lengyela89/Renault-BT/(threads)

Thread 5 (2020-01-20):

Review - CDCE & CDCEM

lengyela89, 2020-01-20:
Fix separator comments in CDCE and CDCEM!

Create API documentation in CDCE and CDCEM!

Replace tabs with spaces!

Create error frame on emulator error, which contains the needed information for debugging:
- error code
- state before error
- error context: additional information

lengyela89, 2020-01-29:
Complex error handling for the CDC Emulator will be implemented later.

Closed 2020-01-29.

Thread 6 (2021-02-24):

Improve error handling

lengyela89, 2021-02-24:
Improve error handling:
 - indicate different type of errors differently on the board
 - use built-in display to inform user about the error
