lengyela89/Renault-BT/Schematics/export/RenaultBT.pdf

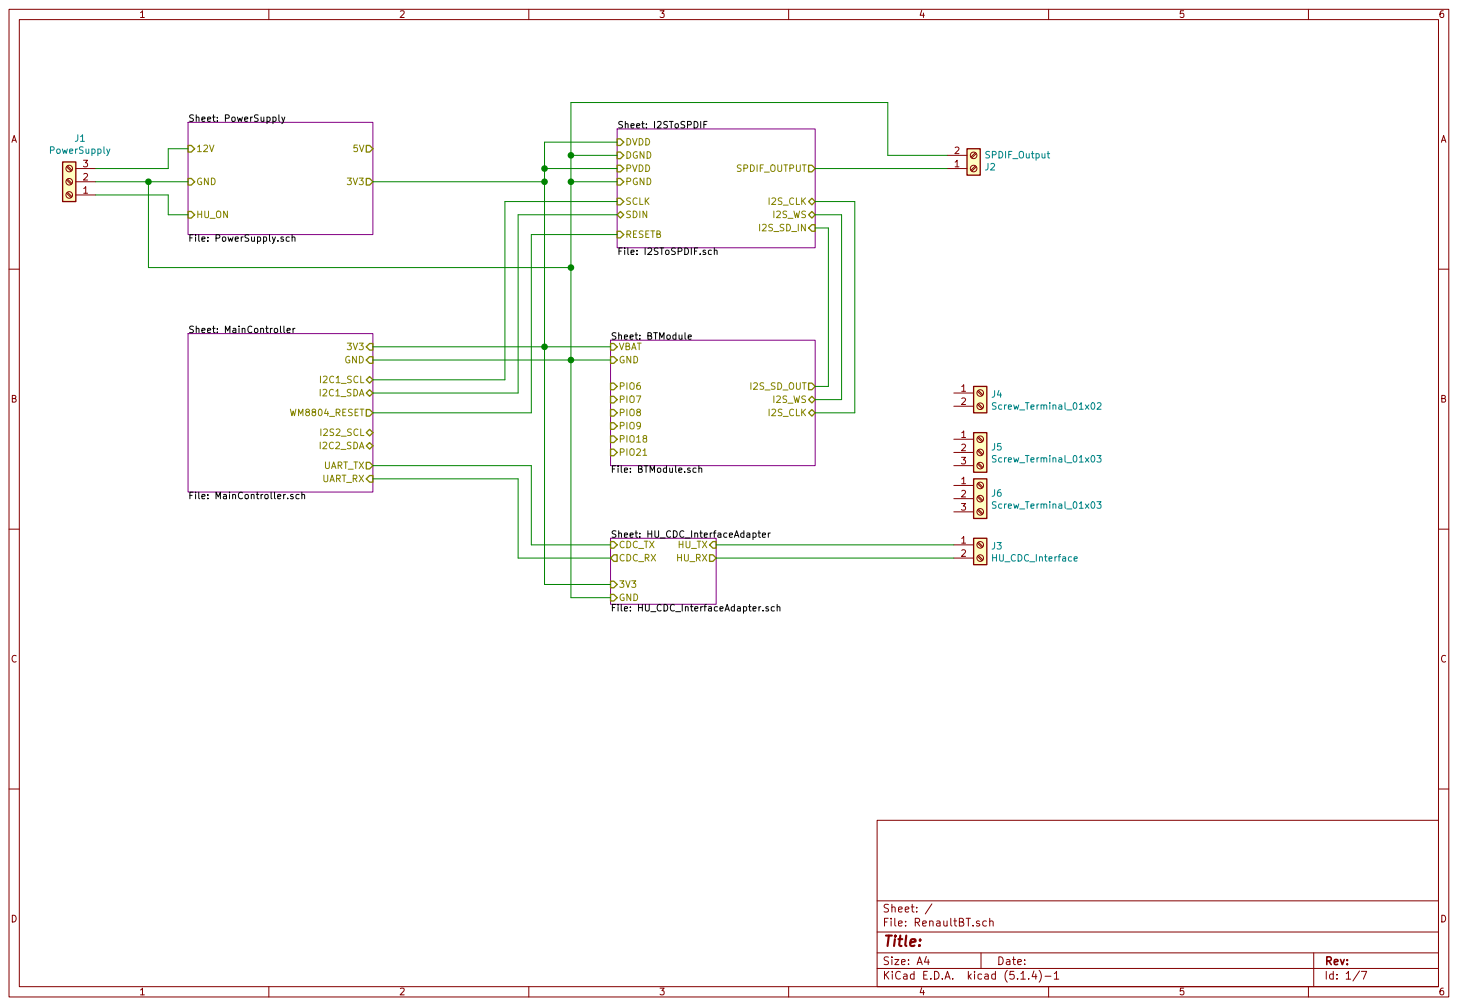
[picture p1: page 1]

3V3 Sheet: MainController File: MainController.sch

Sheet: BTModule File: BTModule.sch VBAT GND

Id: 1/7 Title: File: RenaultBT.sch Sheet: /

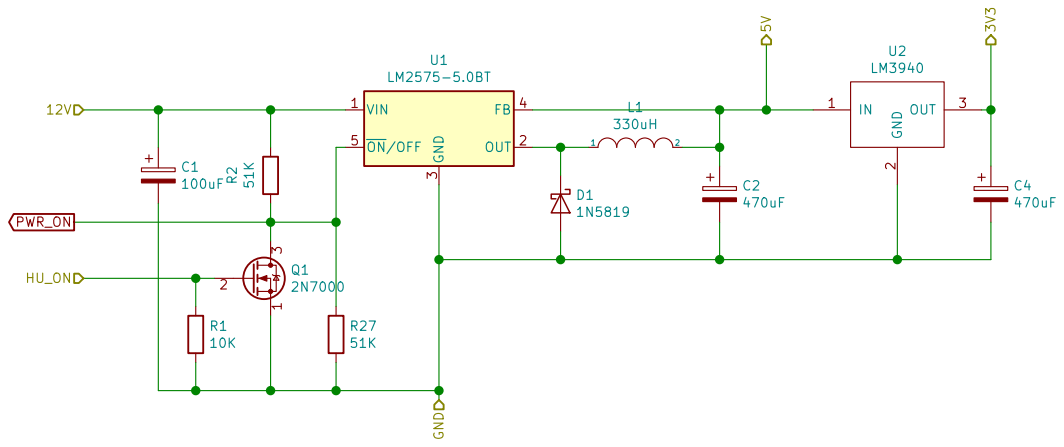
[picture p2: page 2]

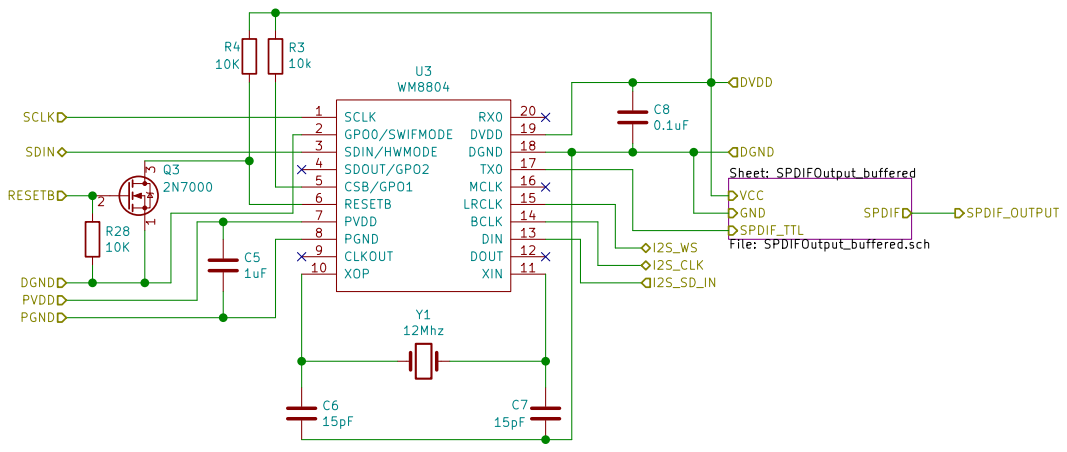
[picture p3: page 3]

Id: 3/7 Title: File: I2SToSPDIF.sch Sheet: /I2SToSPDIF/

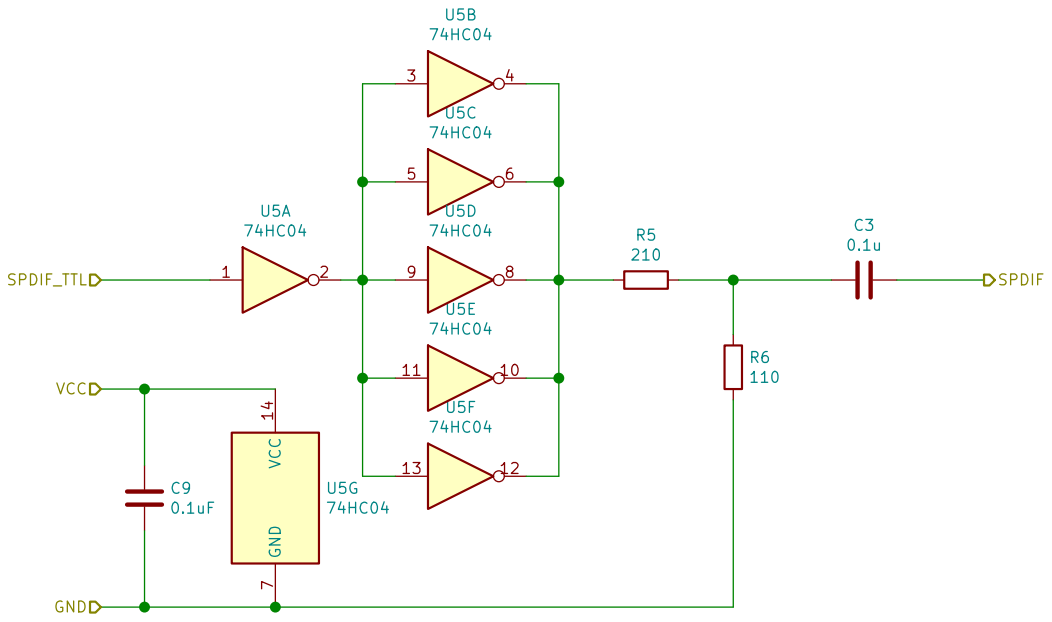
[picture p4: page 4]

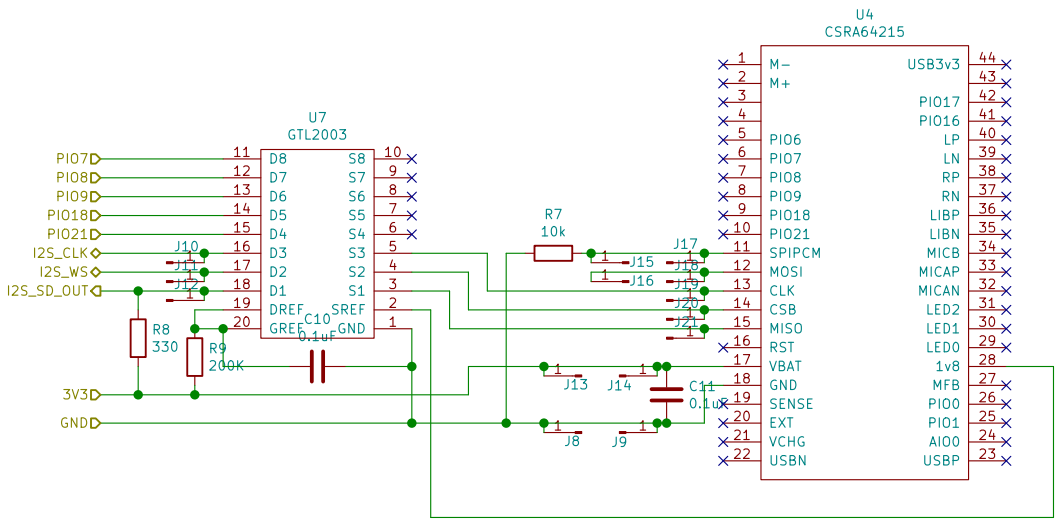
[picture p5: page 5]

Id: 5/7 Title: File: BTModule.sch Sheet: /BTModule/

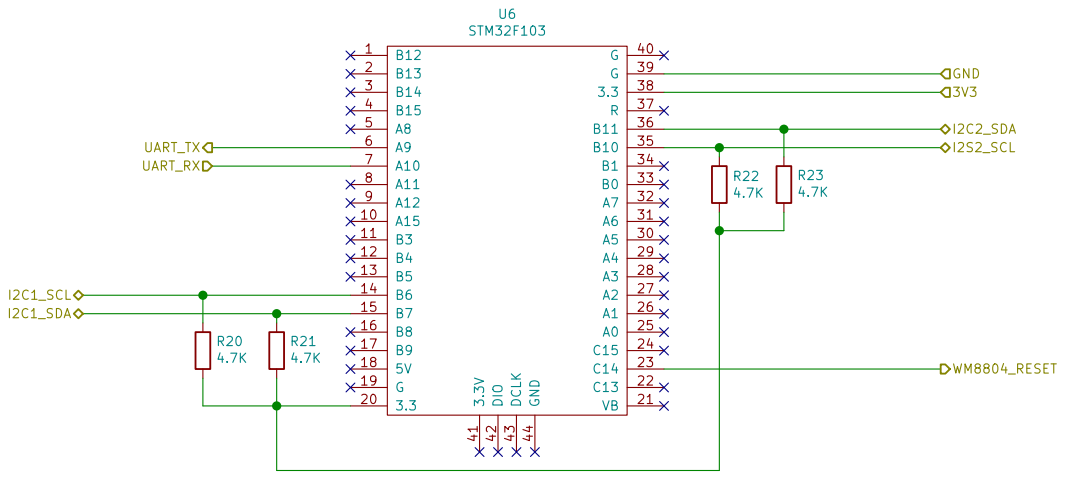
[picture p6: page 6]

Id: 6/7 Title: File: MainController.sch Sheet: /MainController/ R21

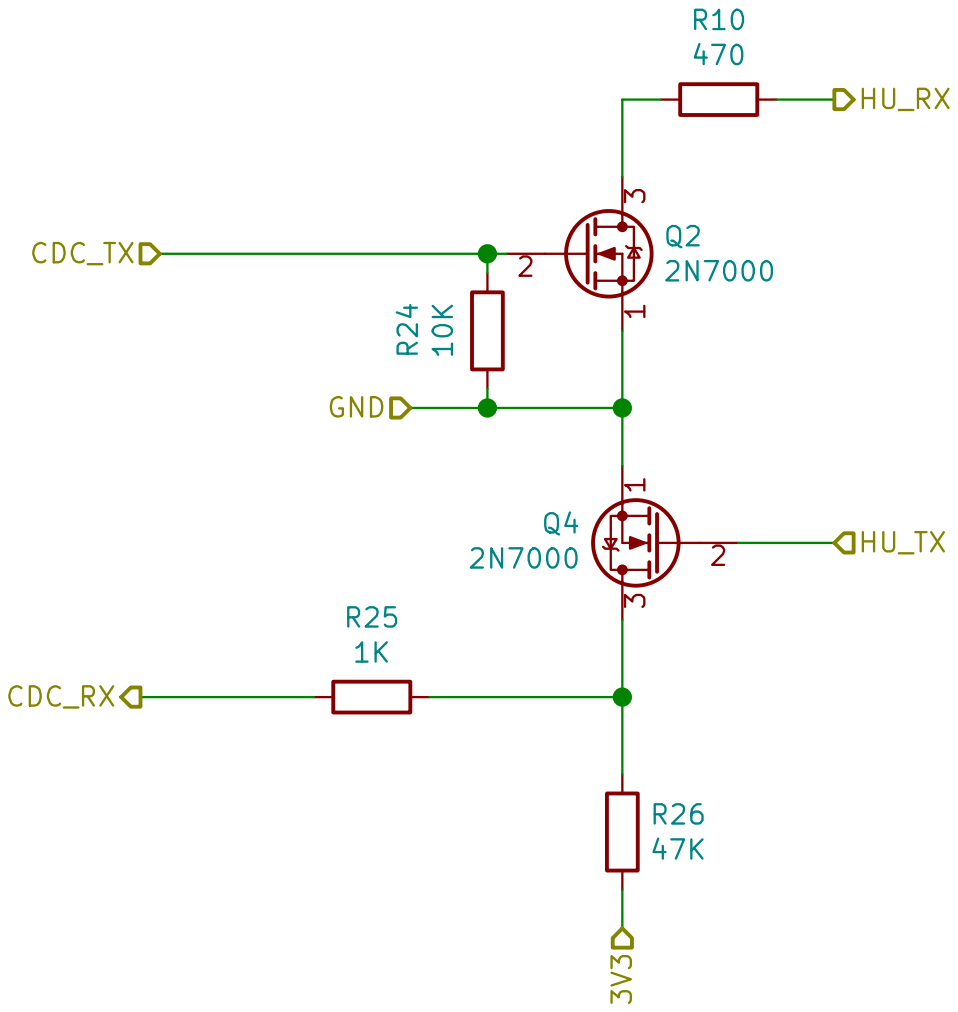
[picture p7: page 7]
