lengyela89/Renault-BT/Schematics/RenaultBT.kicad_pcb

## KiCad design Schematics/RenaultBT.kicad_pcb (2020-01-12)

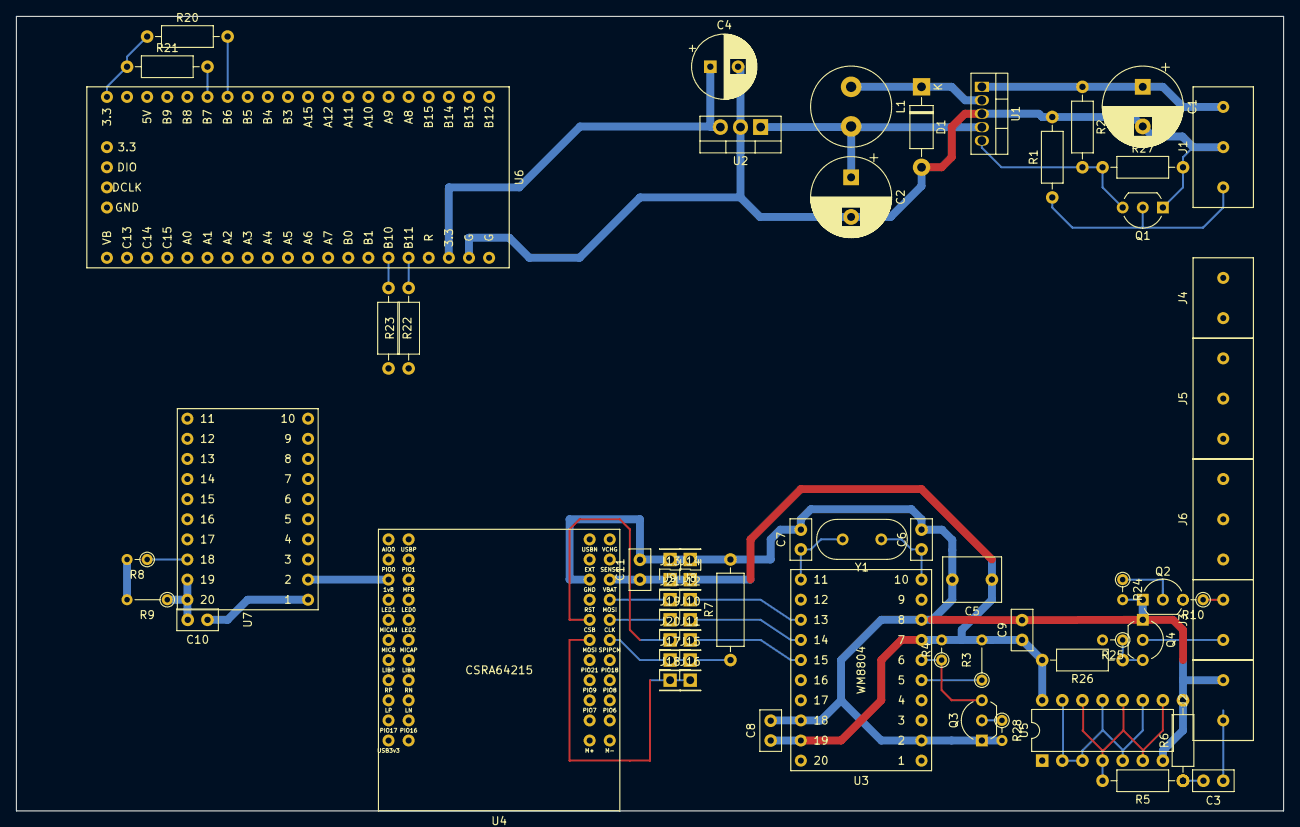
[picture p8: board RenaultBT.kicad_pcb from above]

Board: 2 copper layers, 160.0 x 100.3 mm, 64 parts (0 on the bottom side), 39 nets.

Parts:
C1: 100uF; CP_Radial_D10.0mm_P5.00mm
C2: 470uF; CP_Radial_D10.0mm_P5.00mm
C3: 0.1u; C_Disc_D5.0mm_W2.5mm_P2.50mm
C4: 470uF; CP_Radial_D8.0mm_P3.50mm
C5: 1uF; C_Rect_L7.2mm_W5.5mm_P5.00mm_FKS2_FKP2_MKS2_MKP2
C6, C7: 15pF; C_Disc_D5.0mm_W2.5mm_P2.50mm
C8, C9, C10, C11: 0.1uF; C_Disc_D5.0mm_W2.5mm_P2.50mm
D1: 1N5819; D_DO-41_SOD81_P10.16mm_Horizontal
J1: PowerSupply; ScrewTerminal_3
J2: SPDIF_Output; ScrewTerminal_2
J3: HU_CDC_Interface; ScrewTerminal_2
J4: Screw_Terminal_01x02; ScrewTerminal_2
J5, J6: Screw_Terminal_01x03; ScrewTerminal_3
J8, J9, J10, J11, J12, J13, J14, J15, J16, J17, J18, J19, J20, J21: Conn_01x01_Male; PinHeader_1x01_P2.54mm_Vertical
L1: 330uH; L_Radial_D10.0mm_P5.00mm_Fastron_07M
Q1, Q2, Q3, Q4: 2N7000; TO-92_Inline_Wide
R1: 10K; R_Axial_DIN0207_L6.3mm_D2.5mm_P10.16mm_Horizontal
R2, R27: 51K; R_Axial_DIN0207_L6.3mm_D2.5mm_P10.16mm_Horizontal
R3: 10k; R_Axial_DIN0204_L3.6mm_D1.6mm_P5.08mm_Vertical
R4, R24, R28: 10K; R_Axial_DIN0204_L3.6mm_D1.6mm_P2.54mm_Vertical
R5: 210; R_Axial_DIN0207_L6.3mm_D2.5mm_P10.16mm_Horizontal
R6: 110; R_Axial_DIN0207_L6.3mm_D2.5mm_P10.16mm_Horizontal
R7: 10k; R_Axial_DIN0309_L9.0mm_D3.2mm_P12.70mm_Horizontal
R8: 330; R_Axial_DIN0204_L3.6mm_D1.6mm_P2.54mm_Vertical
R9: 200K; R_Axial_DIN0204_L3.6mm_D1.6mm_P5.08mm_Vertical
R10: 470; R_Axial_DIN0204_L3.6mm_D1.6mm_P2.54mm_Vertical
R20, R21, R22, R23: 4.7K; R_Axial_DIN0207_L6.3mm_D2.5mm_P10.16mm_Horizontal
R25: 1K; R_Axial_DIN0204_L3.6mm_D1.6mm_P2.54mm_Vertical
R26: 47K; R_Axial_DIN0207_L6.3mm_D2.5mm_P10.16mm_Horizontal
U1: LM2575-5.0BT; TO-220-5_Vertical
U2: LM3940; TO-220-3_Vertical
U3: WM8804; WM8804_Breakout_18mm_x_25mm
U4: CSRA64215
U5: 74HC04; DIP-14_W7.62mm
U6: STM32F103; STM32F103C8T6
U7: GTL2003
Y1: 12Mhz; Crystal_HC49-4H_Vertical

Connections:
/BTModule/3V3: C11.1, J13.1, J14.1, R8.2, R9.2, U4.17
/BTModule/I2S_CLK: J10.1, U3.14, U7.16
/BTModule/I2S_WS: J11.1, U3.15, U7.17
/HU_CDC_InterfaceAdapter/3V3: C4.1, C5.1, C8.1, C9.1, R3.2, R4.2, R26.2, U2.3, U3.7, U3.19, U5.14, U6.38
/HU_CDC_InterfaceAdapter/CDC_RX: R25.2, U6.7
/HU_CDC_InterfaceAdapter/CDC_TX: Q2.2, R24.1, U6.6
/HU_CDC_InterfaceAdapter/HU_RX: J3.2, R10.1
/HU_CDC_InterfaceAdapter/HU_TX: J3.1, Q4.2
/I2SToSPDIF/DGND: C1.2, C2.2, C4.2, C5.2, C6.2, C7.2, C8.2, C9.2, C10.1, C11.2, D1.2, J1.2, J2.2, J8.1, J9.1, Q1.1, Q2.1, Q3.1, Q4.1, R1.2, R6.2, R7.2, R24.2, R27.2, R28.2, U1.3, U2.2, U3.2, U3.8, U3.18, U4.18, U5.7, U6.39, U7.1
/I2SToSPDIF/I2S_SD_IN: J12.1, R8.1, U3.13, U7.18
/I2SToSPDIF/RESETB: Q3.2, R28.1, U6.23
/I2SToSPDIF/SPDIFOutput_buffered/SPDIF_TTL: U3.17, U5.1
/I2SToSPDIF/SPDIF_OUTPUT: C3.1, J2.1
/MainController/I2C1_SCL: R20.2, U3.1, U6.14
/MainController/I2C1_SDA: R21.2, U3.3, U6.15
/MainController/I2C2_SDA: R23.2, U6.36
/MainController/I2S2_SCL: R22.1, U6.35
/PowerSupply/5V: C2.1, L1.2, U1.4, U2.1
/PowerSupply/12V: C1.1, J1.3, R2.1, U1.1
/PowerSupply/HU_ON: J1.1, Q1.2, R1.1
unnamed: C3.2, R5.1, R6.1
unnamed: C6.1, U3.10, Y1.1
unnamed: C7.1, U3.11, Y1.2
unnamed: C10.2, R9.1, U7.19, U7.20
unnamed: D1.1, L1.1, U1.2
unnamed: J15.1, J17.1, R7.1, U4.11
unnamed: J16.1, J18.1, U4.12
unnamed: J19.1, U4.13, U7.5
unnamed: J20.1, U4.14, U7.4
unnamed: J21.1, U4.15, U7.3
unnamed: Q2.3, R10.2
unnamed: Q3.3, R4.1, U3.6
unnamed: Q4.3, R25.1, R26.1
unnamed: R3.1, U3.5
unnamed: R5.2, U5.4, U5.6, U5.8, U5.10, U5.12
unnamed: R20.1, R21.1, R22.2, R23.1, U6.20
unnamed: U4.28, U7.2
unnamed: U5.2, U5.3, U5.5, U5.9, U5.11, U5.13
PWR_ON: Q1.3, R2.2, R27.1, U1.5
