lengyela89/Renault-BT/Src/main.c

/**
 ******************************************************************************
 * File Name          : main.c
 * Description        : Main program body
 ******************************************************************************
 ** This notice applies to any and all portions of this file
 * that are not between comment pairs USER CODE BEGIN and
 * USER CODE END. Other portions of this file, whether
 * inserted by the user or by software development tools
 * are owned by their respective copyright owners.
 *
 * COPYRIGHT(c) 2019 STMicroelectronics
 *
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
 ******************************************************************************
 */

/* Includes ------------------------------------------------------------------*/
#include "main.h"
#include "stm32f1xx_hal.h"

/* USER CODE BEGIN Includes */
#include <WM8804.h>
#include <CDCEmulator.h>
/* USER CODE END Includes */

I2C_HandleTypeDef hi2c1;
I2C_HandleTypeDef hi2c2;

UART_HandleTypeDef huart1;

/* USER CODE BEGIN PV */

/* USER CODE END PV */

void SystemClock_Config(void);
static void MX_GPIO_Init(void);
static void MX_I2C1_Init(void);
static void MX_I2C2_Init(void);
static void MX_USART1_UART_Init(void);

/* USER CODE BEGIN PFP */
static void errorHandling(void);
/* USER CODE END PFP */

/* USER CODE BEGIN 0 */
static void errorHandling(void)
{
    while (1)
    {
        HAL_GPIO_TogglePin(GPIOC, LED_Pin);
        HAL_Delay(500u);
    }
}
/* USER CODE END 0 */

int main(void)
{

    /* MCU Configuration----------------------------------------------------------*/

    /* Reset of all peripherals, Initializes the Flash interface and the Systick. */
    HAL_Init();

    /* Configure the system clock */
    SystemClock_Config();

    /* Initialize all configured peripherals */
    MX_GPIO_Init();
    MX_I2C1_Init();
    MX_I2C2_Init();
    MX_USART1_UART_Init();

    /* USER CODE BEGIN 2 */
    uint32_t result = WM8804_RC__OK;

    WM8804_ResetPinConfig resetPinConfig = {
        .GPIOPeripheral = WM8804_RESET_GPIO_Port,
        .GPIOPin = WM8804_RESET_Pin,
        .activeLow = false
    };

    result |= WM8804_initialize(&hi2c1, 0x76u, resetPinConfig);

    if (!result)
    {
        result |= WM8804_configureModule();
    }

    if (!result)
    {
        CDCE_Config cdceConfig = { .huart = &huart1 };

        result |= CDCE_configure(cdceConfig);
    }

    if (!result)
    {
        result |= CDCE_start();
    }

    if (result)
    {
        /*
         * If an error occurred, error handler is called!
         */
        errorHandling();
    }

    /* USER CODE END 2 */

    /* Infinite loop */
    /* USER CODE BEGIN WHILE */
    while (1)
    {
        /* USER CODE END WHILE */

        /* USER CODE BEGIN 3 */
    }
    /* USER CODE END 3 */

}

/** System Clock Configuration
 */
void SystemClock_Config(void)
{

    RCC_OscInitTypeDef RCC_OscInitStruct;
    RCC_ClkInitTypeDef RCC_ClkInitStruct;

    /**Initializes the CPU, AHB and APB busses clocks 
     */
    RCC_OscInitStruct.OscillatorType = RCC_OSCILLATORTYPE_HSI;
    RCC_OscInitStruct.HSIState = RCC_HSI_ON;
    RCC_OscInitStruct.HSICalibrationValue = 16;
    RCC_OscInitStruct.PLL.PLLState = RCC_PLL_ON;
    RCC_OscInitStruct.PLL.PLLSource = RCC_PLLSOURCE_HSI_DIV2;
    RCC_OscInitStruct.PLL.PLLMUL = RCC_PLL_MUL9;
    if (HAL_RCC_OscConfig(&RCC_OscInitStruct) != HAL_OK)
    {
        _Error_Handler(__FILE__, __LINE__);
    }

    /**Initializes the CPU, AHB and APB busses clocks 
     */
    RCC_ClkInitStruct.ClockType = RCC_CLOCKTYPE_HCLK | RCC_CLOCKTYPE_SYSCLK
            | RCC_CLOCKTYPE_PCLK1 | RCC_CLOCKTYPE_PCLK2;
    RCC_ClkInitStruct.SYSCLKSource = RCC_SYSCLKSOURCE_PLLCLK;
    RCC_ClkInitStruct.AHBCLKDivider = RCC_SYSCLK_DIV1;
    RCC_ClkInitStruct.APB1CLKDivider = RCC_HCLK_DIV1;
    RCC_ClkInitStruct.APB2CLKDivider = RCC_HCLK_DIV1;

    if (HAL_RCC_ClockConfig(&RCC_ClkInitStruct, FLASH_LATENCY_1) != HAL_OK)
    {
        _Error_Handler(__FILE__, __LINE__);
    }

    /**Configure the Systick interrupt time 
     */
    HAL_SYSTICK_Config(HAL_RCC_GetHCLKFreq() / 1000);

    /**Configure the Systick 
     */
    HAL_SYSTICK_CLKSourceConfig(SYSTICK_CLKSOURCE_HCLK);

    /* SysTick_IRQn interrupt configuration */
    HAL_NVIC_SetPriority(SysTick_IRQn, 0, 0);
}

/* I2C1 init function */
static void MX_I2C1_Init(void)
{

    hi2c1.Instance = I2C1;
    hi2c1.Init.ClockSpeed = 100000;
    hi2c1.Init.DutyCycle = I2C_DUTYCYCLE_2;
    hi2c1.Init.OwnAddress1 = 0;
    hi2c1.Init.AddressingMode = I2C_ADDRESSINGMODE_7BIT;
    hi2c1.Init.DualAddressMode = I2C_DUALADDRESS_DISABLE;
    hi2c1.Init.OwnAddress2 = 0;
    hi2c1.Init.GeneralCallMode = I2C_GENERALCALL_DISABLE;
    hi2c1.Init.NoStretchMode = I2C_NOSTRETCH_DISABLE;
    if (HAL_I2C_Init(&hi2c1) != HAL_OK)
    {
        _Error_Handler(__FILE__, __LINE__);
    }

}

/* I2C2 init function */
static void MX_I2C2_Init(void)
{

    hi2c2.Instance = I2C2;
    hi2c2.Init.ClockSpeed = 100000;
    hi2c2.Init.DutyCycle = I2C_DUTYCYCLE_2;
    hi2c2.Init.OwnAddress1 = 0;
    hi2c2.Init.AddressingMode = I2C_ADDRESSINGMODE_7BIT;
    hi2c2.Init.DualAddressMode = I2C_DUALADDRESS_DISABLE;
    hi2c2.Init.OwnAddress2 = 0;
    hi2c2.Init.GeneralCallMode = I2C_GENERALCALL_DISABLE;
    hi2c2.Init.NoStretchMode = I2C_NOSTRETCH_DISABLE;
    if (HAL_I2C_Init(&hi2c2) != HAL_OK)
    {
        _Error_Handler(__FILE__, __LINE__);
    }

}

/* USART1 init function */
static void MX_USART1_UART_Init(void)
{

    huart1.Instance = USART1;
    huart1.Init.BaudRate = 9600;
    huart1.Init.WordLength = UART_WORDLENGTH_9B;
    huart1.Init.StopBits = UART_STOPBITS_1;
    huart1.Init.Parity = UART_PARITY_EVEN;
    huart1.Init.Mode = UART_MODE_TX_RX;
    huart1.Init.HwFlowCtl = UART_HWCONTROL_NONE;
    huart1.Init.OverSampling = UART_OVERSAMPLING_16;
    if (HAL_UART_Init(&huart1) != HAL_OK)
    {
        _Error_Handler(__FILE__, __LINE__);
    }

}

/** Configure pins as 
 * Analog
 * Input
 * Output
 * EVENT_OUT
 * EXTI
 */
static void MX_GPIO_Init(void)
{

    GPIO_InitTypeDef GPIO_InitStruct;

    /* GPIO Ports Clock Enable */
    __HAL_RCC_GPIOC_CLK_ENABLE()
    ;
    __HAL_RCC_GPIOB_CLK_ENABLE()
    ;
    __HAL_RCC_GPIOA_CLK_ENABLE()
    ;

    /*Configure GPIO pin Output Level */
    HAL_GPIO_WritePin(GPIOC, LED_Pin | WM8804_RESET_Pin, GPIO_PIN_RESET);

    /*Configure GPIO pin Output Level */
    HAL_GPIO_WritePin(GPIOB, GPIO_PIN_15 | GPIO_PIN_9, GPIO_PIN_RESET);

    /*Configure GPIO pins : LED_Pin WM8804_RESET_Pin */
    GPIO_InitStruct.Pin = LED_Pin | WM8804_RESET_Pin;
    GPIO_InitStruct.Mode = GPIO_MODE_OUTPUT_PP;
    GPIO_InitStruct.Speed = GPIO_SPEED_FREQ_LOW;
    HAL_GPIO_Init(GPIOC, &GPIO_InitStruct);

    /*Configure GPIO pins : PB14 PB8 */
    GPIO_InitStruct.Pin = GPIO_PIN_14 | GPIO_PIN_8;
    GPIO_InitStruct.Mode = GPIO_MODE_INPUT;
    GPIO_InitStruct.Pull = GPIO_NOPULL;
    HAL_GPIO_Init(GPIOB, &GPIO_InitStruct);

    /*Configure GPIO pins : PB15 PB9 */
    GPIO_InitStruct.Pin = GPIO_PIN_15 | GPIO_PIN_9;
    GPIO_InitStruct.Mode = GPIO_MODE_OUTPUT_PP;
    GPIO_InitStruct.Speed = GPIO_SPEED_FREQ_LOW;
    HAL_GPIO_Init(GPIOB, &GPIO_InitStruct);

}

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
