lengyela89/Renault-BT/Renault-BT.ioc

Mcu.UserName=STM32F103C8Tx
PA10.Signal=USART1_RX
PA13.Signal=SYS_JTMS-SWDIO
PA14.Signal=SYS_JTCK-SWCLK
PA9.Signal=USART1_TX
PB10.Signal=I2C2_SCL
PB11.Signal=I2C2_SDA
PB14.Signal=GPIO_Input
PB15.Signal=GPIO_Output
PB6.Signal=I2C1_SCL
PB7.Signal=I2C1_SDA
PB8.Signal=GPIO_Input
PB9.Signal=GPIO_Output
PC13-TAMPER-RTC.GPIO_Label=LED
PC13-TAMPER-RTC.Signal=GPIO_Output
PC14-OSC32_IN.GPIO_Label=WM8804_RESET
PC14-OSC32_IN.Signal=GPIO_Output
