lengyela89/Renault-BT/(commit log)

2019-04-24 Added schematics (KiCAD project)
    [PowerSupply.sch, RenaultBT.kicad_pcb, RenaultBT.sch]
2019-04-24 Added WM8804 library
    [RenaultBT.kicad_pcb, RenaultBT.sch]
2019-06-19 Added BT module, HU-CDC interface adapter, I2S to SPDIF converter, SPDIF interface and main controller to the schematics
    [BTModule.sch, BTModule_ButtonIF_3v3Divider.sch, BTModule_ButtonIF_Divider.sch, HU_CDC_InterfaceAdapter.sch, I2SToSPDIF.sch, MainController.sch, PowerSupply.sch, RenaultBT.csv]
2019-06-20 Modified power supply
    [PowerSupply.sch, RenaultBT.csv, RenaultBT.kicad_pcb]
2019-06-21 Fixed library path errors; added edge-cut for PCB; added screw connector to the schematic
    [BTModule.sch, BTModule_ButtonIF_3v3Divider.sch, HU_CDC_InterfaceAdapter.sch, I2SToSPDIF.sch, MainController.sch, PowerSupply.sch, RenaultBT.kicad_pcb, RenaultBT.sch]
2019-06-21 Added foorprint for screw terminals; simplified power supply; PCB partial design
    [PowerSupply.sch, RenaultBT.kicad_pcb, RenaultBT.sch]
2019-06-23 Fixed library settings; modified PCB design
    [BTModule.sch, BTModule_ButtonIF_3v3Divider.sch, HU_CDC_InterfaceAdapter.sch, I2SToSPDIF.sch, MainController.sch, PowerSupply.sch, RenaultBT.kicad_pcb, RenaultBT.sch]
2019-06-24 Updated PCB design
    [RenaultBT.kicad_pcb]
2019-07-03 Modified PCB design
    [BTModule.sch, BTModule_ButtonIF_3v3Divider.sch, HU_CDC_InterfaceAdapter.sch, I2SToSPDIF.sch, MainController.sch, PowerSupply.sch, RenaultBT.kicad_pcb, RenaultBT.sch]
2019-07-18 Modified power supply schematic and PCB design; added new library for lm3940 IC.
    [PowerSupply.sch, RenaultBT.kicad_pcb]
2019-07-23 Modified power supply schematic: changed C4 output capacitor to 470uF
    [BTModule.sch, BTModule_ButtonIF_3v3Divider.sch, HU_CDC_InterfaceAdapter.sch, I2SToSPDIF.sch, MainController.sch, PowerSupply.sch, RenaultBT.sch, SPDIFOutput_buffered.sch]
2019-07-31 Updated power supply schematic and PCB design
    [BTModule.sch, BTModule_ButtonIF_3v3Divider.sch, HU_CDC_InterfaceAdapter.sch, I2SToSPDIF.sch, MainController.sch, PowerSupply.sch, RenaultBT.kicad_pcb, RenaultBT.sch]
2019-08-08 Fixed CDC interface schematic; Fixed SPDIF output interface schematic; Added screw terminals; Modified PCB design
    [BTModule.sch, HU_CDC_InterfaceAdapter.sch, I2SToSPDIF.sch, PowerSupply.sch, RenaultBT.kicad_pcb, RenaultBT.sch, SPDIFOutput_buffered.sch]
2019-08-08 Added C9 bypass capacitor; minor PCB design fixes
    [RenaultBT.kicad_pcb, SPDIFOutput_buffered.sch]
2019-08-08 Minor PCB design fixes
    [RenaultBT.kicad_pcb, SPDIFOutput_buffered.sch]
2019-08-09 Minor fixes in PCB design
    [RenaultBT.kicad_pcb]
2019-08-12 Added R28 to Q3 between pin 1 and 2; Updated PCB design
    [I2SToSPDIF.sch, RenaultBT.kicad_pcb]
2019-10-28 Fixed voltage level issues between BT module and WM8804; fixed CDC Emulator hw interface; modified PCB design
    [BTModule.sch, HU_CDC_InterfaceAdapter.sch, I2SToSPDIF.sch, MainController.sch, PowerSupply.sch, RenaultBT.kicad_pcb, RenaultBT.sch, SPDIFOutput_buffered.sch]
2020-01-12 Updated schematic and PCB design (minor modifications on layout)
    [BTModule.sch, MainController.sch, RenaultBT.kicad_pcb, SPDIFOutput_buffered.sch]
2020-01-13 Replaced tabs with spaces in WM8804 lib
    [WM8804.c, WM8804.h]
2020-01-24 Fixed separator comments in CDCE and CDCEM
    #5
    [CDCEMessage.c, CDCEMessage.h, CDCEmulator.c, CDCEmulator.h]
2020-01-26 Tabs are replaced with spaces in CDCE and CDCEM
    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
    [CDCEMessage.c, CDCEMessage.h, CDCEmulator.c, CDCEmulator.h]
2020-01-29 Added E_UNKNOWN error code to CDCE.
    E_UNKNOWN error is returned from CDCE_start function if any kind of
    error occured during the execution of the emulator.
    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
    [CDCEmulator.c, CDCEmulator.h, main.c]
2020-02-02 Renamed original config file to csra64215_config__original.psr and renamed modified config file to csra64215_config__modified.psr.
    Modifications on the original configuration:
    - Device was renamed to RENAULT-BT
    - Audio settings:
    - I2S - Slave operation
    - I2S - Left justified
    - I2S - No delay
    - I2S - 20 bits per sample
    - I2S - Music resampling frequency: 48kHz
    - Routing: I2S
    - Audio HW for I2S output: PCM Block 1
    - Audio input routing: internal
    - Party mode: OFF
    - AVRCP: Enabled
    - A2DP volume level: HFP 15; A2DP streaming is enabled; Codecs: AAC, aptX, aptX low latency
    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
2020-08-25 Exported schematics to PDF and SVG.
    [BTModule.sch, HU_CDC_InterfaceAdapter.sch, I2SToSPDIF.sch, MainController.sch, PowerSupply.sch, RenaultBT.sch, SPDIFOutput_buffered.sch]
