lengyela89/Renault-BT/(notices)

Notices in the files:
Src/main.c:
(C) COPYRIGHT STMicroelectronics *****END OF FILE
